LauMahecha/Robotica/Corte_1/Lab_1_y_2_Informe.pdf

INFORME DE PRACTICA DE LABORATORIO | Versi ´ | on 1.0 ´
PROGRAMA DE INGENIERÍA MECATRONICA | Periodo 2026-1 ´
Diseno, Modelado Cinematogr ˜ | afico y Control de ´

# Bajo Nivel de un Manipulador Tipo SCARA

Mahecha Mahecha Laura Julieth, Gonzalez Palacios Wilson Andres, Salmanca Arevalo Cristian Andres y Rodriguez Romero Santiago
Profesor: Velasco Vivas Alexandra
I. INTRODUCCION´

El presente informe presenta el desarrollo integral de un
robot SCARA, el cual es disenado espec ˜ | íficamente para la
manipulacion de piezas ligeras en una celda de manufactura. ´ Este proyecto abarca desde la seleccion de materiales y ´ actuadores, pasando por el modelado matematico mediante ´ los parametros de Denavit-Hartenberg y toda su respectiva ´
configuracion, hasta la implementaci ´ | on de sistemas de control ´
PID de bajo nivel en una plataforma ESP32.

II. OBJETIVOS

Desarrollar la plataforma y el diseno mec ˜ anico del robot ´ utilizando herramientas CAD, optimizando la estructura
mediante impresion 3D y sistemas de transmisi ´ | on en ´
acero para garantizar durabilidad y ligereza.
Obtener el modelo matematico de cinem ´ | atica directa a ´
traves de la metodolog ´ | ía de DH, permitiendo determinar
la posicion del efector final en el espacio del trabajo. ´ Implementar el control PID en un micro, en este cado la ESP32 para gestionar la posicion y velocidad de ´ las articulaciones, utilizando retroalimentacion de los ´ respectivos encoders
Validar los calculos de troque y velocidad mediante simu- ´ laciones para asegurar que los actuadores seleccionados realicen la tarea asignada
Disenar una interfaz gr ˜ | afica de usuario (GUI) que permita ´
el comando remoto del manipulador y la visualizacion de ´ su estado cinematico en tiempo real ´
Integrar un sistema de sujecion por vaci ´ | o (ventosa) como ´
efector final para minimizar la inercia del sistema y
facilitar la manipulacion de objetos esf ´ | ericos ´

III. DESARROLLO DE LA PRACTICA ´

III-A. Justificaciones tecnicas de la arquitectura y selecci ´ | on´
de componentes
Arquitectura Del Manipulador: Se ha seleccionado
una configuracion cinem ´ | atica tipo SCARA (RRP) ya ´
que seria la opcion mas eficiente para la tarea de en- ´ samble requerida. Dado que la operacion que se desea ´ desempenar es tomar piezas en este caso un ping pong y ˜

El presente documento corresponde a un informe de practica de laboratorio ´ de “Robotica” presentado en la Universidad Militar Nueva Granada durante ´ el periodo 2026-1.

posicionarlas sobre una base, el robot SCARA nos ofrece
un eje prismatico el cual cumplir ´ | ía con ese requisito.
Seleccion De Materiales Y Transmisi ´ | on: ´ | En base al
diseno estructural hemos seleccionado imprimirlos en 3D ˜ algunas secciones, como lo son los brazos, ya que estos mismos van a ser huecos, por el simple hecho de que van a tener engranajes y cables en su interior, todo esto con el fin de optimizar el espacio, ya para la parte de potencia, hemos escogido utilizar unos engranajes de acero.

Actuadores Y Control: Para cumplir con los parametros ´ debidamente calculados, decidimos utilizar motores DC con cajas reductoras de engranajes matalicos acoplados a encoders de efecto hall, ya que al implementar el uso del
encoder nos permitira hacer un control tanto de posici ´ | | on´
como de velocidad.
Efector Final (Ventosa De vacio): ´ Se descarto una pinza mecanica y se procedio a implementar un sistema ´
de succion por vaci ´ | o, ya que se realiza con el fin ´
de optimizar la masa, es decir, reducir el peso en eje prismatico del robot.

Lista de Actuadores y Sensores:

Actuadores:
Los actuadores son los encargados de generar el movimiento físico y la sujecion en el robot. ´
1. Motorreductor DC con Encoder (x3) Especificaciones: Modelo 25GA470, alimentacion de ´ 12V DC, velocidad de salida de 100 RPM. Consiste en un motor de corriente continua con escobillas acoplado a una caja reductora metalica. Cumple con la normativa ´ del proyecto de no usar servomotores. Cuenta con un encoder magnetico de cuadratura (canales A y B) en el ´ eje trasero del motor para medir la posicion y velocidad ´ real, permitiendo un control en lazo cerrado para cada articulacion (Hombro, Codo y Eje Z). ´
2. Bomba de Vacío de Membrana
Especificaciones: 12V DC, 300mA. Es el componente activo del efector final para agarrar objetos.
3. Ventosa / Chupa de Silicona

Especificaciones: Diametro de Ø40mm. Trabaja en con- ´ junto con la bomba y el sistema de vacío en el extremo del Eje Z.

Sensores:

Los sensores se encargan de medir el estado del sistema para enviar retroalimentacion (feedback) al controlador. ´

1. Encoders Rotativos (x3)

Especificaciones: 600 PPR (Pulsos Por Revolucion), ali- ´ mentacion de 3.3V. Hay uno acoplado a cada motor (M1, M2 ´ y M3) para monitorear la posicion real de los ejes y crear un ´ sistema de lazo cerrado.

III-B. Diseno CAD del Entorno y Configuraci ˜ | on del Robot ´

Justificacion de la Arquitectura (SCARA) ´

La rubrica permite la selecci ´ | on entre una arquitectura ´
Antropomorfica (RRR) o SCARA (RRP). Para esta l ´ | ínea
de ensamble, se ha seleccionado y disenado una topolog ˜ | ía
SCARA (RRP). Esta decision se justifica por la naturaleza de ´ la tarea: un proceso de (tomar y poner) sobre una superficie plana. El robot SCARA ofrece una alta rigidez en el eje vertical (Z), lo que es ideal para soportar la carga al presionar o depositar las esferas en los agujeros de la base, mientras que sus dos articulaciones rotacionales proporcionan movimientos rapidos y precisos en el plano horizontal (XY). ´


Figura 1. Diseno CAD ˜

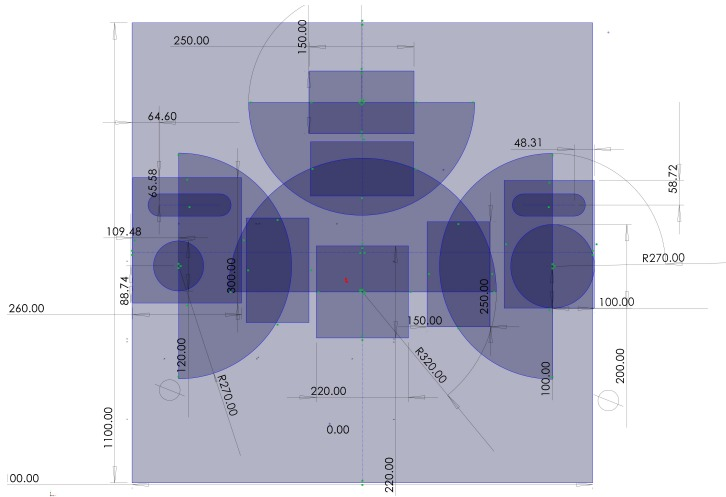
[picture p3: figure]

Figura 3. Espacio de trabajo

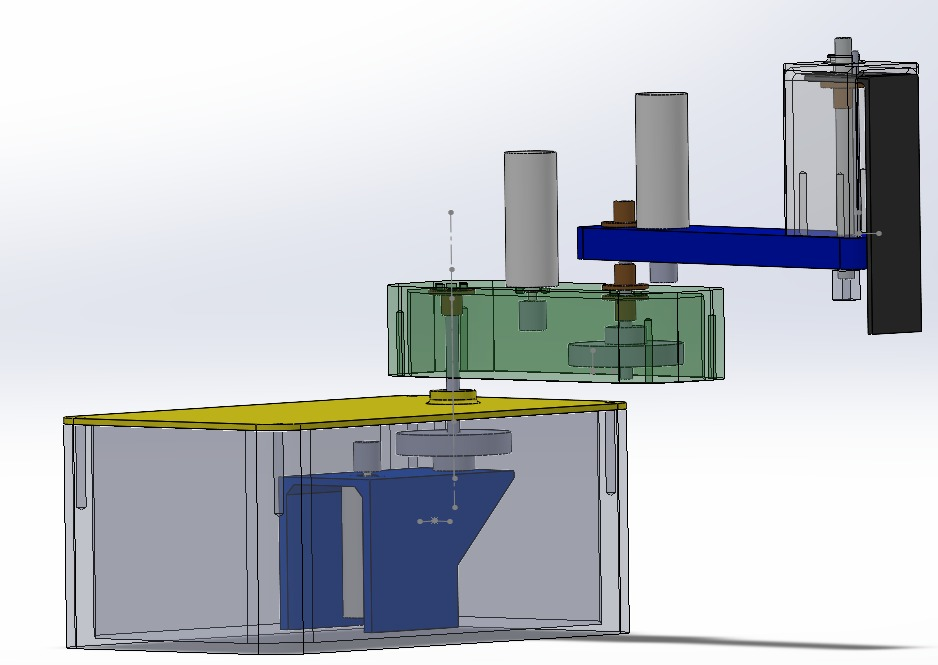
[picture p4: figure]

Figura 2. Diseno CAD ˜

Este diseno fue elegido debido a su alta rigidez en el eje ˜ Z y por su facilidad de controlar el aspecto de la velocidad al momento de hacer la tarea de recoger y colocar los componentes ligeros en este laboratorio.
Como podemos ver el cada parte se a hecho con un volumen cilíndrico hueco, determinado por los limites cinematicos de ´ los eslabones de 112 mm y 155 mm, con ello su alcance
maximo radical es de 267 mm, permitiendo as ´ | í cubrir la
totalidad del area de ensamble que fue asignado, cabe aclarar ´ que esto permite evitar singularidades dentro de la zona de operacion´
Configuracion del Entorno y Espacio de Trabajo ´
III-C. Descripcion de la L ´ | ínea de Ensamble
De acuerdo con los requerimientos del proyecto, se ha
disenado una celda de manufactura contenida en un ˜ | area ´
cuadrada de 1.1 × 1.1 metros (cumpliendo con la restriccion´
maxima de ´ | 1.25 m de arista). El sistema consiste en una línea
de ensamble dividida en tres estaciones de trabajo indepen-dientes. El objetivo central de la celda es el acoplamiento de tres esferas de material ligero (∅ 40 mm, correspondientes a pelotas de ping-pong) en una base rectangular de 25×15×1.5 cm.
Para garantizar que el ensamble no entre en contacto con el
suelo del laboratorio en ningun momento, el dise ´ | no del entorno ˜
incluye soportes físicos elevados en cada estacion. Estos ´ soportes aseguran la fijacion temporal de la base mientras se ´ realiza la insercion de las piezas. ´

III-D. Analisis del Espacio de Trabajo (Workspace) ´

El entorno CAD (Ver Figura 1 y 3) revela la distribucion´ espacial de los manipuladores. Se han definido zonas de trabajo específicas marcadas por las envolventes cinematicas ´ de los robots:
Estacion Central: ´ | Posee un radio maximo de alcance de ´
R = 320 mm. Esta dimension fue calculada para garanti- ´ zar que el efector final pueda alcanzar tanto el repositorio de piezas (fuera de la línea central de ensamble) como los agujeros correspondientes en la base.
Estaciones Laterales: Cuentan con un radio de alcance de R = 270 mm. Al estar ubicadas estrategicamente en ´ los flancos de la línea, requieren una menor extension de ´ eslabones para cubrir su area designada en la superficie ´ de la base.
Dado que los robots operan a una altura superior al suelo mediante los soportes disenados, el volumen de trabajo de cada ˜ robot SCARA se define como un sector cilíndrico. La altura de
este cilindro (carrera del eje prismatico Z) est ´ | a dimensionada ´
para descender desde una cota de seguridad hasta la altura de la base (1.5 cm de espesor) y los repositorios, cumpliendo con
la restriccion de velocidad m ´ | axima de ´ | 0.15 m/s exigida para
articulaciones prismaticas. ´

III-E. Materiales y Consideraciones de Fabricacion´

Para cumplir con los criterios de integridad estructural y baja inercia, los eslabones principales de los robots SCARA y la base del entorno estan dise ´ nados en materiales livia- ˜ nos y de alta resistencia. Atendiendo a las restricciones de
diseno, ˜ | ningun elemento encargado de la transmisi ´ | on de ´
movimiento (engranajes, poleas, pinones) ser ˜ | a fabricado en ´
madera, plastico o mediante t ´ | ecnicas de prototipado r ´ | apido ´
(impresion 3D), garantizando el uso de elementos de transmi- ´ sion met ´ alicos normalizados para reducir la probabilidad de ´ falla y holgura mecanica . ´

III-F. Calculos De Torque Y Velocidades De Los Motores ´

Se realizo un analisis din ´ | amico considerando las inercias ´
de los eslabones, los sistemas de transmision en acero y la ´
carga transportada. Calculos Din ´ | amicos y Requerimientos ´
de Torque Para garantizar que los actuadores seleccionados (motorreductores 25GA470 de 12V y 100 RPM) sean capaces de mover la estructura cumpliendo con las restricciones de
velocidad de la rubrica, se realiz ´ | o un an ´ | alisis din ´ | amico del ´
manipulador.
III-G. Parametros F ´ | ísicos del Modelo
A partir del diseno en CAD y la selecci ˜ | on de materiales, ´
se extrajeron las siguientes variables de diseno para el c ˜ | alculo ´
de inercias y torques:
Longitudes de eslabones: Brazo 1 (L1 = 0.112 m) y Brazo 2 (L2 = 0.155 m).
Masas estructurales: Brazo 1 (m1 = 0.2 kg), Brazo 2 (m2 = 0.25 kg) y Eje Z con efector final (m3 = 0.15 kg).
Carga util: ´ Masa de la pieza a ensamblar (mc = 0.003 kg).
Aceleracion angular: ´ | Se establecio un perfil de mo- ´
vimiento con una aceleracion´ | α = 4 rad/s²
| | para las
articulaciones rotacionales.

III-H. Analisis del Eje 1 (Base/Hombro) ´

El motor de la base (J1) es el encargado de mover la mayor cantidad de masa, por lo que experimenta la mayor inercia del sistema. El momento de inercia calculado para este eje es:

I1 = 0.02072 kg · m

2

Aplicando la segunda ley de Newton para la rotacion, el torque ´
dinamico requerido para acelerar el conjunto a ´ | | 4 rad/s² es:

τ1 = I1 · α = 0.1 Nm

III-I. Analisis del Eje 2 (Codo) ´

El segundo eslabon transporta menos masa al no tener que ´ cargar con el Brazo 1. Su momento de inercia respecto a su propio eje de rotacion es significativamente menor: ´

I2 = 0.005677 kg · m

2

Por lo tanto, el torque dinamico necesario para la articulaci ´ | | on´
J2 es:
τ2 = I2 · α = 0.02271 Nm

Las articulaciones J1 y J2 requieren una velocidad maxima de ´ 2 rad/s, lo que equivale a 19.098 RPM. Dado que los motores seleccionados proporcionan 100 RPM nominales, operaran´
holgadamente y requeriran limitaci ´ | on por PWM o reducci ´ | on´
mecanica para no exceder la velocidad permitida. ´
III-J. Analisis del Eje 3 (Articulaci ´ | on Prism ´ | atica) ´

El movimiento vertical del Eje Z debe contrarrestar la fuerza de gravedad ejercida por su propia masa y la carga util. La ´ fuerza gravitacional total en el eje es de 1.5 N.Para lograr la conversion de movimiento rotacional a lineal cumpliendo ´ con la velocidad exigida de 0.15 m/s, se analizaron dos
mecanismos de transmision. Se opt ´ | o por un sistema de ´ | pinõn- ´
cremallera con un radio de pinõn´ r = 0.01 m. Para alcanzar la velocidad lineal maxima exigida, el motor J3 debe girar a: ´

ω3 =

v
r

=

0.15 m/s
0.01 m

= 15 rad/s ≈ 143.31 RPM

El torque requerido para vencer la gravedad mediante este sistema de pinõn-cremallera se establece en: ´

τ3 = Fz · r = 1.5 N · 0.01 m = 0.015 Nm

Como el torque maximo demandado por el sistema es de ´ 0.1 Nm (en el Eje 1), los motor-reductores 25GA470 son completamente aptos para la tarea, operando sin riesgo de sobrecarga o bloqueo.
Justificacion Adicional de Subsistemas ´

III-K. Diseno del Efector Final (Sistema de Agarre) ˜

Para la tarea de manipulacion ( ´ pick-and-place) de las piezas de ensamble (esferas de material ligero de ∅ 40 mm), se
evaluaron distintas alternativas de sujecion. Se descart ´ | o el uso ´
de pinzas mecanicas (grippers) debido a que su accionamiento ´ requiere actuadores adicionales en el extremo del brazo, lo cual incrementaría significativamente la masa (m3), la inercia del sistema y la complejidad del control.
En su lugar, se opto por un ´ | sistema de sujecion por vac ´ | ío.
La solucion propuesta est ´ | a compuesta por: ´
Una ventosa o copa de sujecion de silicona de ´ | 40 mm
de diametro, que se adapta perfectamente a la curvatura ´
de la esfera, garantizando un sello hermetico sin da ´ | nar ˜
la pieza.
Una bomba de vacío de membrana accionada a 12V DC, ubicada estrategicamente en la base del robot o en el Eje ´ Z para minimizar el momento de inercia.
Un modulo rel ´ | e de 5V (SRD-05VDC) comandado por ´
un pin digital del microcontrolador ESP32, aislando la etapa de potencia de la etapa logica. ´
Este diseno resulta ser mucho m ˜ | as ligero, r ´ | apido de accionar ´
y energeticamente eficiente para la carga ´ | util espec ´ | ífica del
proyecto (0.003 kg).
Calculos Te ´ | oricos: Cinem ´ | atica Directa (20 %) ´
El modelo cinematico directo de un manipulador permite ´
determinar la posicion y orientaci ´ | on del efector final en el ´
espacio cartesiano (x, y, z) a partir de los valores articulares dados (angulos de los motores y desplazamiento lineal). Para el ´ robot SCARA (arquitectura RRP) propuesto, se ha empleado
la convencion de Denavit-Hartenberg (D-H) est ´ | andar para ´
asignar los sistemas de coordenadas a cada eslabon. ´

III-L. Parametros de Denavit-Hartenberg ´

A partir del diseno CAD establecido, se definen los siguien- ˜
tes parametros geom ´ | etricos: ´
L0: Altura de la base hasta el plano del primer brazo.
L1: Longitud del primer eslabon ( ´ | 0.112 m).
L2: Longitud del segundo eslabon ( ´ | 0.155 m).
d3: Desplazamiento de la articulacion prism ´ | atica (Eje Z), ´
el cual es variable.

La Tabla 1 resume los parametros D-H del manipulador, ´
donde θi es el angulo de la articulaci ´ | on, ´ | di el desfase en el
eslabon, ´ | ai
la longitud del eslabon y ´ | αi el giro del eslabon. ´

A partir del diseno CAD establecido, se evidencian desfases ˜ verticales debido al montaje superpuesto de los eslabones y la ubicacion del actuador final. Se definen los siguientes ´
parametros geom ´ | etricos (en metros): ´

Tabla I
PARAMETROS ´ | DENAVIT-HARTENBERG REALES DEL ROBOT SCARA
DISENADO ˜
Articulacion ( ´ | i) | θi (Angulo Z) ´ | di (Desfase Z) | ai (Longitud X) | αi (Giro X)
1 (Hombro) | θ1
∗ | 0.063 | 0.112 | 0
| | | | | ◦
2 (Codo) | θ2
∗ | 0.115 | 0.155 | 180◦
3 (Eje Z) | 0 | 0.148 | 0.035 | 0
| | | | | ◦

(*) Variables articulares. Valores de di y ai expresados en metros.

III-M. Matrices de Transformacion Homog ´ | enea ´
Aplicando la matriz de transformacion general de D-H ´ A

i−1
i

, se obtienen las matrices individuales para cada articulacion: ´

A

0
1 =

cos(θ1) − sin(θ1) 0 L1 cos(θ1)
sin(θ1) | cos(θ1) | 0 L1 sin(θ1)
0 | 0 | 1 | L0
0 | 0 | 0 | 1

(1)

A

1
2 =

cos(θ2) | sin(θ2) | 0 | L2 cos(θ2)
sin(θ2) − cos(θ2) | 0 | L2 sin(θ2)
0 | 0 | −1 | 0
0 | 0 | 0 | 1

(2)

A

2
3 =

1 0 0 | 0
0 1 0 | 0
0 0 1 d3
0 0 0 1

(3)

III-N. Ecuaciones Finales de Posicion´
La matriz de transformacion total ´ | T

0
3 que relaciona el
efector final con la base del robot se obtiene mediante la
multiplicacion sucesiva de las matrices individuales ( ´ | | T
| | 0 3 =
A⁰
1
- A¹
2
- A²
3

). Al resolver esta multiplicacion, se extrae el ´ vector de posicion cartesiana: ´

Px = L1 cos(θ1) + L2 cos(θ1 + θ2) | (4)
Py = L1 sin(θ1) + L2 sin(θ1 + θ2) | (5)
| Pz = L0 − d3 | (6)

Estas tres ecuaciones parametricas constituyen el modelo ´
cinematico directo. Ser ´ | an utilizadas posteriormente por el ´
algoritmo de control para validar la posicion del robot dentro ´ del espacio de trabajo y evitar colisiones con los soportes de la base de ensamble.
Validacion del Modelo Cinem ´ | atico en Simulaci ´ | on´
Para garantizar la fiabilidad del modelo matematico desa- ´
rrollado en la seccion de Cinem ´ | atica Directa, se procedi ´ | o a ´
realizar una validacion computacional mediante simulaci ´ | | on. ´
Para este proposito, se emple ´ | o el software MATLAB Online ´
junto con el Robotics Toolbox de Peter Corke.

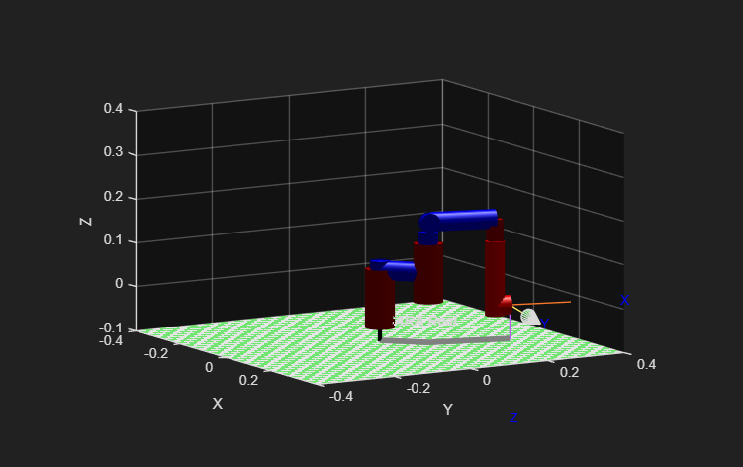
[picture p5: figure]

Figura 4. Simulacion del brazo scara en el software Matlab

III-N. ˜ | Implementacion en Simulaci ´ | on´

El robot SCARA fue instanciado utilizando la clase SerialLink. Se configuraron las articulaciones 1 y 2 mediante la clase Revolute y la articulacion 3 median- ´ te Prismatic, ingresando los parametros de Denavit- ´ Hartenberg (D-H) calculados previamente.
En la figura 4 se observa el modelado espacial del robot generado por la funcion´ plot().

III-O. Analisis de Resultados y Ecuaciones Finales ´
Al aplicar los parametros reales del dise ´ | no CAD en la ˜
multiplicacion de las matrices de Denavit-Hartenberg, las ´
ecuaciones parametricas de posici ´ | on espacial para el efector ´
final (coordenadas X, Y, Z) se definen como:
Px = a1 cos(θ1) + (a2 + a3) cos(θ1 + θ2) | (7)
Py = a1 sin(θ1) + (a2 + a3) sin(θ1 + θ2) | (8)
Pz = d1 + d2 − offset3 − d3 | (9)
Para la validacion del modelo, se evalu ´ | o un vector articular ´
de prueba q = [45◦
| , 30◦ , 0.05 m] T
en las ecuaciones analíticas desarrolladas, obteniendo:

Px = 0.112 cos(45◦

) + (0.155 + 0.035) cos(75◦
| | ) = 0.1284 m (10)

Py = 0.112 sin(45◦

) + (0.155 + 0.035) sin(75◦
| | ) = 0.2627 m (11)
Pz = 0.063 + 0.115 − 0.148 − 0.05 = −0.0200 m | (12)

Estos resultados teoricos se compararon directamente con ´
el vector de posicion extra ´ | ído de la matriz de transformacion´
homogenea calculada por la funci ´ | on´ | fkine del Robotics
Toolbox:

PT oolbox =

0.1284
0.2627
−0.0200
- m | (13)

La coincidencia exacta hasta la cuarta cifra decimal entre el desarrollo analítico propio y el calculo matricial de la si- ´
mulacion valida de manera concluyente el modelo cinem ´ | atico ´
directo del manipulador.

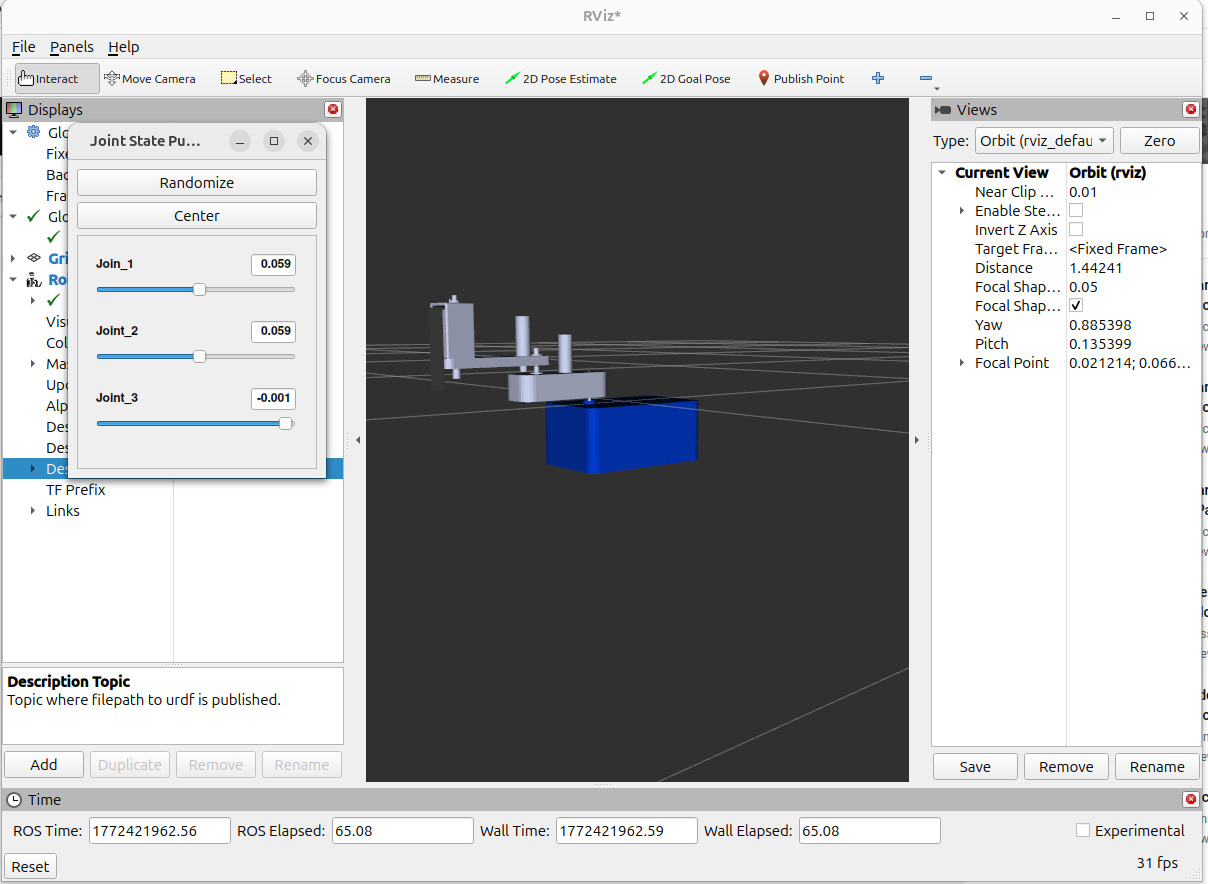
[picture p6: figure]

Figura 5. Simulacion del robot scara en el software ROS2

Simulacion en el entorno ROS2 ´
Para el entorno en ROS2 en primera instancia se generó el URDF desde el SOLIDWORKS, apoyando la geometría, ejes de referencia y puntos de origen del robot en cada una de sus articulaciones, así mismo se verifico que la accion de ´ cada punto correspondiera de acuerdo a la geometría propia del robot, una vez generado esto se procede a desde el RViZ desde el cual se configuro para ls visualizacion, se creo un ´ work space con los ejecutables del ros2. Así mismo dentro del RVIZ se configuran algunos sliders con los que se permite el movimiento en cada articulacion. Se observa en la figura 5 ´ respectivamente.

Desarrollo de la Interfaz Grafica de Usuario (GUI) ´ Para visualizar y validar el comportamiento cinematico del ´

manipulador SCARA de forma interactiva, se desarrollo una ´ Interfaz Grafica de Usuario (GUI) utilizando el lenguaje de ´ programacion Python. ´
La aplicacion se construy ´ | o integrando las siguientes li- ´
brerías principales:
Tkinter: Utilizada para estructurar la ventana principal, los paneles de control y los elementos de interaccion´ (deslizadores y cuadros de texto).
NumPy: Empleada para el manejo matricial eficiente,
permitiendo el calculo en tiempo real de la cinem ´ | atica ´
directa mediante la multiplicacion de las matrices de ´
transformacion homog ´ | enea de Denavit-Hartenberg. ´
Matplotlib: Implementada para generar un entorno tridi-mensional (espacio de trabajo) incrustado en la interfaz, donde se renderizan los eslabones del robot.

III-P. Estructura y Funcionamiento de la GUI
Como se observa en la figura 5, la interfaz esta dividida en ´ dos secciones principales:
1. Panel de Control (Izquierda): Permite al usuario mo-dificar los parametros articulares del robot de manera ´

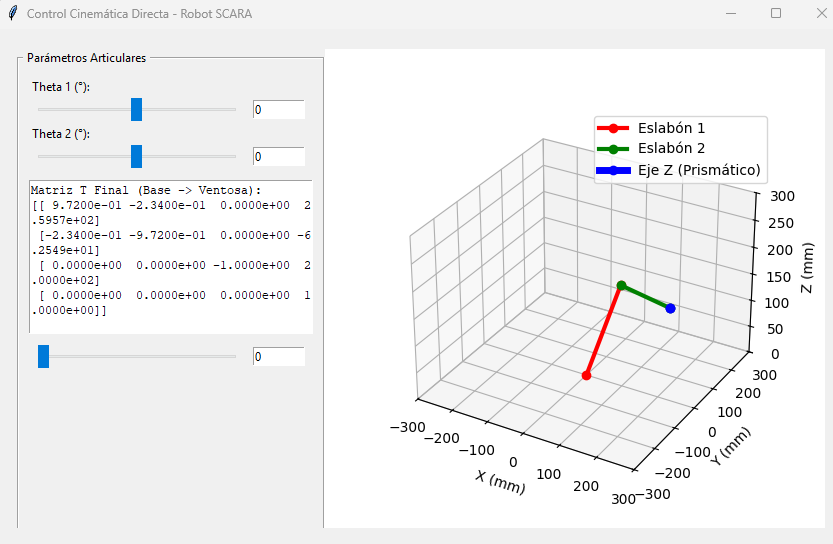
[picture p7: figure]

Figura 6. Interfaz Grafica de Usuario para el control cinem ´ | atico directo del ´
robot SCARA

manual. Cuenta con controles deslizantes (sliders) para
los angulos de las articulaciones rotacionales ( ´ | θ1 y θ2)
y para el desplazamiento lineal del efector final (d3).
Ademas, incluye un ´ | area de texto que imprime en tiempo ´
real la Matriz de Transformacion Homog ´ | enea resultante ´
desde la base hasta la ventosa/efector.
2. Simulador 3D (Derecha): Muestra una representacion´ grafica y simplificada de la estructura del manipulador. ´
Esta visualizacion se actualiza din ´ | amicamente cada vez ´
que el usuario modifica un parametro en el panel iz- ´ quierdo, permitiendo observar la postura final del robot
(posicion y orientaci ´ | on) dentro de su espacio de trabajo. ´
Esta herramienta interactiva permite corroborar visual y
matematicamente que los l ´ | ímites de las articulaciones y las
longitudes de los eslabones coinciden con el diseno CAD ˜ propuesto, sirviendo como un entorno de validacion integral ´ previo a la implementacion f ´ ísica o al control dinamico. ´

III-Q. Plano Electrico

Como se observa en el diagrama general del sistema (Ver Figura 8), la arquitectura electronica se divide en cuatro ´ bloques funcionales principales:
Unidad de Procesamiento: El nucleo del sistema es ´ un microcontrolador ESP32-WROOM. Este dispositivo gestiona la generacion de pulsos para los motores, la ´ lectura de los encoders y la comunicacion con la interfaz ´ de usuario.
Etapa de Potencia y Accionamiento: El movimiento de los ejes se realiza mediante tres motores paso a paso NEMA 17. Cada motor es controlado por un driver
A4988, los cuales reciben las senales de ˜ | Step y Direction
desde los pines GPIO del ESP32. El Eje Z cuenta con un mecanismo de tornillo de bolas para la traslacion vertical. ´
Sistema de Retroalimentacion (Lazo Cerrado): ´ | Para
garantizar la precision posicional, se han implementado ´ tres encoders magneticos de cuadratura (600 PPR). Estos ´ sensores envían pulsos constantes al ESP32 (Pines GPIO

34-39 y 18-19), permitiendo corregir desviaciones en tiempo real.
Gestion de Energ ´ | ía: El sistema utiliza una fuente de
12V DC para la etapa de potencia (motores y bomba).
Para la etapa logica, se integra un regulador ´ | | AMS1117-
5V que suministra un voltaje estable al microcontrolador
y al modulo rel ´ | e.´
Efector Final de Succion: ´ | El control del agarre se realiza
mediante un modulo rel ´ | e de 5V que activa una ´ | bomba de
vacío de membrana. El sistema incluye un diodo flyback para la proteccion contra corrientes inversas durante la ´ conmutacion. ´

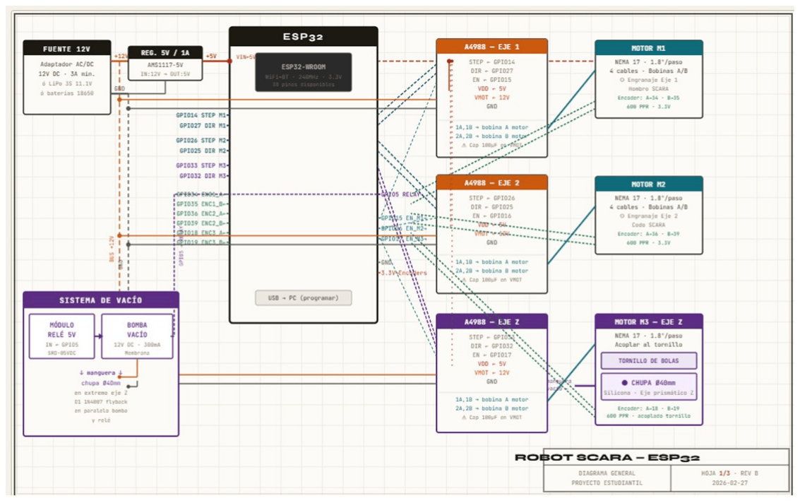
[picture p8: figure]

Figura 7. Diagrama esquematico detallado del sistema de control y potencia ´ del Robot SCARA - ESP32.

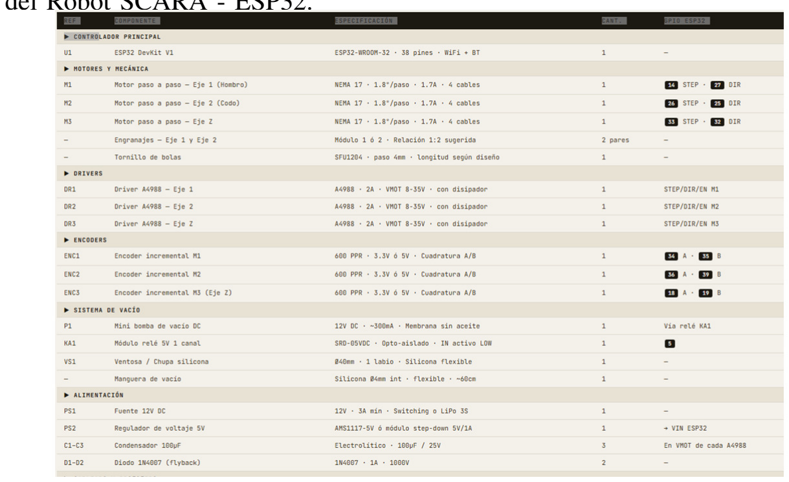
[picture p9: figure]

Figura 8. Diagrama esquematico 2 ´

III-R. Especificaciones de Interconexion´
La Tabla II resume la asignacion de pines cr ´ | íticos identi-
ficados en el diseno, asegurando la integridad de las se ˜ | nales ˜
entre la etapa de control y los actuadores.

Tabla II
RESUMEN DE ASIGNACION DE ´ | PINES GPIO DEL ESP32.
Componente | Senales de Control ˜ | Pines GPIO
Motor Eje 1 (Hombro) | Step / Dir / En | 14, 27, 15
Motor Eje 2 (Codo) | Step / Dir / En | 26, 25, 16
Motor Eje Z (Prismatico) ´ | Step / Dir / En | 33, 32, 17
Modulo Rel ´ e (Vac ´ ío) | Activacion´ | 5

III-S. Descripcion de Componentes Mec ´ | anicos ´
Como se detalla en la Figura 6, el conjunto mecanico utiliza ´ piezas fabricadas mediante manufactura aditiva (impresion´ 3D) para las carcasas y soportes, mientras que los elementos críticos de transmision emplean materiales de alta resistencia. ´ Estructura Base y Brazos: Las piezas como la Base Robot (1) y el Brazo 2 (9) han sido disenadas para ˜ alojar internamente el cableado y los actuadores, optimizando el volumen de trabajo.
Transmision de Movimiento: ´ | Se utilizan Varillas de
Acero (6) para garantizar la rigidez estructural. La transmision se realiza mediante un sistema de poleas ´ (4 y 5) que conectan los motores con las articulaciones rotacionales.
Eje Prismatico Z: ´ | Para el movimiento vertical, se em-
plea un Tornillo de Bolas (12) acoplado a una guía lineal, lo cual garantiza la precision necesaria para la tarea de ´ ensamble.

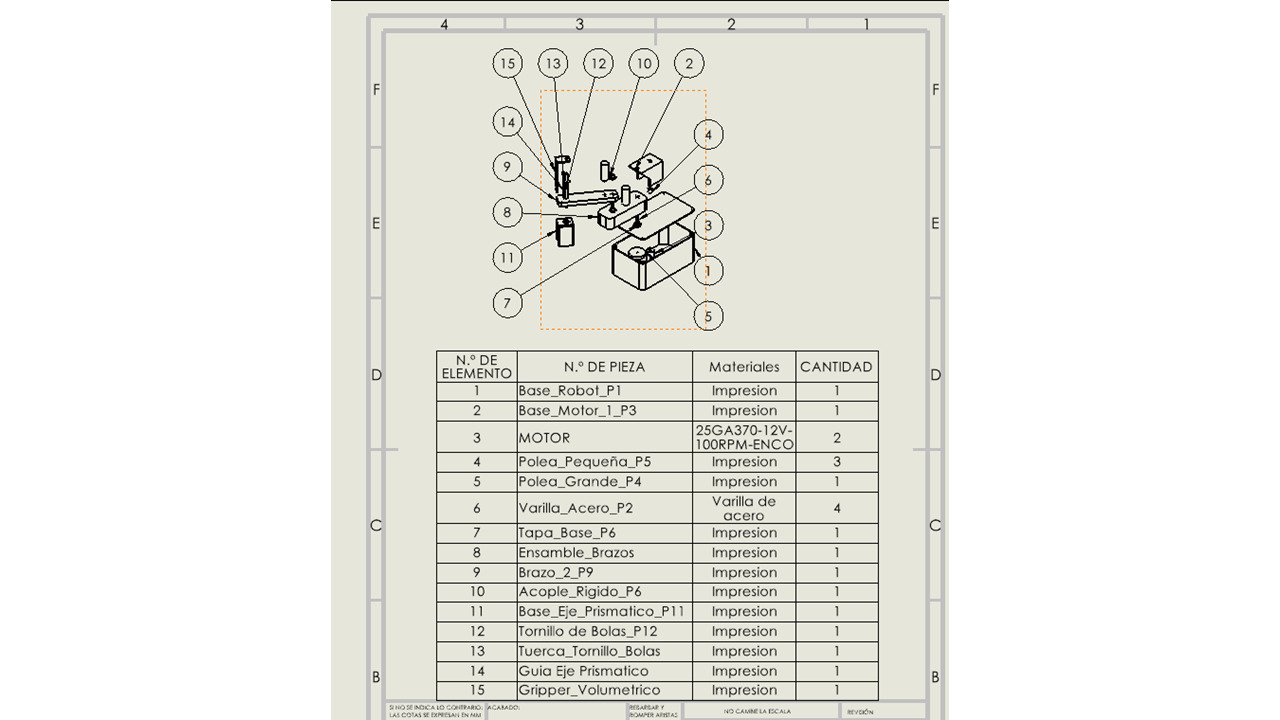
[picture p10: figure]

Figura 9. Plano mecanico con vista explosionada y lista de materiales (BOM). ´

Analisis de Resultados: Control en Cascada ´
La implementacion del control en cascada para el motor ´ 25GA370 permite desacoplar efectivamente las dinamicas de ´
velocidad y posicion[cite: 364, 367]. A continuaci ´ | | on se deta- ´
llan los hallazgos obtenidos en la fase de diseno y simulaci ˜ | on. ´

III-T. Identificacion y Planta ´
Los parametros identificados mediante el script de ´ MATLAB revelan una resistencia de armadura Ra = 8.00 Ω y una inductancia La = 0.0050 H[cite: 203, 208]. La constante de torque Kt y la constante de fuerza contraelectromotriz Kb
resultaron identicas con un valor de ´ | 0.6867 en unidades del
sistema internacional [cite: 209, 210], lo que confirma una operacion bajo condiciones de eficiencia ideal[cite: 204]. ´

III-U. Control de Velocidad (Lazo Interno)
El lazo interno fue disenado para un tiempo de estable- ˜
cimiento ts = 0.5 s y un sobreimpulso maximo del ´ | 5 %[cite:
266, 271]. Los parametros del controlador PID resultantes son ´ Kp = 15.00, Ki = 40.00 y Kd = 0.0500[cite: 268, 274].
La respuesta ante un escalon de ´ | | 1 rad/s muestra una
convergencia rapida y sin error de estado estacionario debido ´
a la accion integral[cite: 299]. La se ´ | nal de error ˜ | ev(t) decae

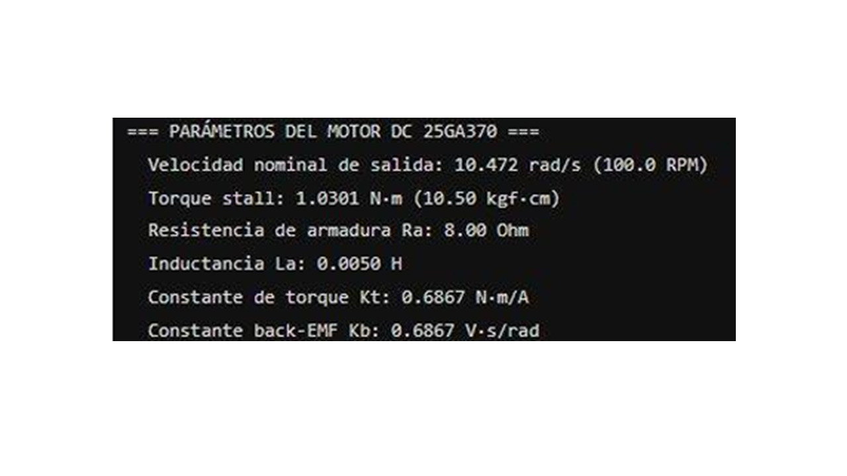
[picture p11: figure]

Figura 10. Variables de estado y parametros electromec ´ | anicos calculados para ´
el motor 25GA370[cite: 211].

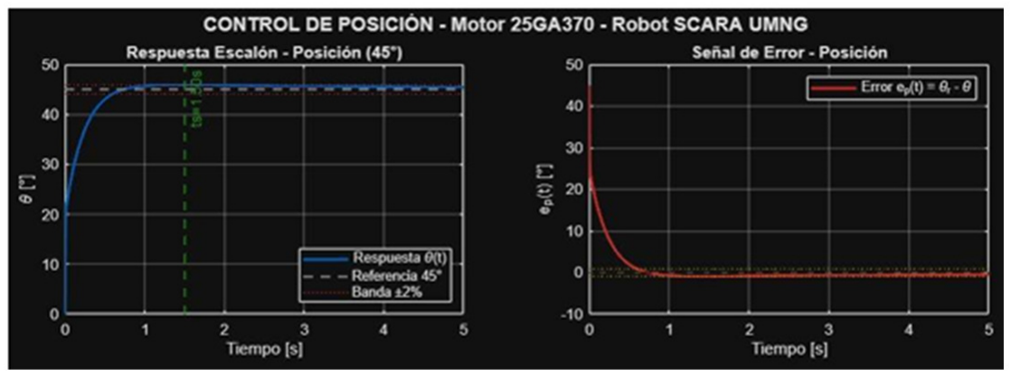
[picture p12: figure]

Figura 11. Respuesta transitoria ante un escalon de ´ 45◦ y seguimiento de la referencia de posicion[cite: 330, 363]. ´

exponencialmente, entrando en la banda de tolerancia del 2 % antes del límite previsto de 0.5 s[cite: 300, 329].

III-V. Control de Posicion (Lazo Externo) ´
Para el lazo de posicion, se establecieron criterios de dise ´ | nõ
de ts = 2.0 s y un sobreimpulso del 10 %[cite: 283, 287]. Los valores sintonizados para este controlador son Kp = 8.00, Ki = 1.50 y Kd = 0.800[cite: 284, 287].
III-W. Separacion de Din ´ | amicas ´
La estabilidad del sistema en cascada se fundamenta en la separacion de las constantes de tiempo entre ambos lazos[cite: ´ 367]. El lazo interno de velocidad responde en aproximadamente 0.3 s, mientras que el lazo externo de posicion lo hace ´ en un rango de 1.5 a 2.0 s[cite: 366]. Esta diferencia, con un factor de aproximadamente 5-7 veces, asegura que la dinamica ´ interna no interfiera negativamente con el seguimiento de posicion[cite: 367]. ´
IV. ANALISIS ´ | DE RESULTADO

Podemos ver y saber que al momento de realizar un control de velocidad y de posicion se comporta bastante acorde a los parametros y con respecto a las ganancias que les dimos, no obstante cabe aclarar que a pesar de que cada motor tenga la misma referencia se comportan de manera diferente, es decir, las ganancias pueden cambiar.

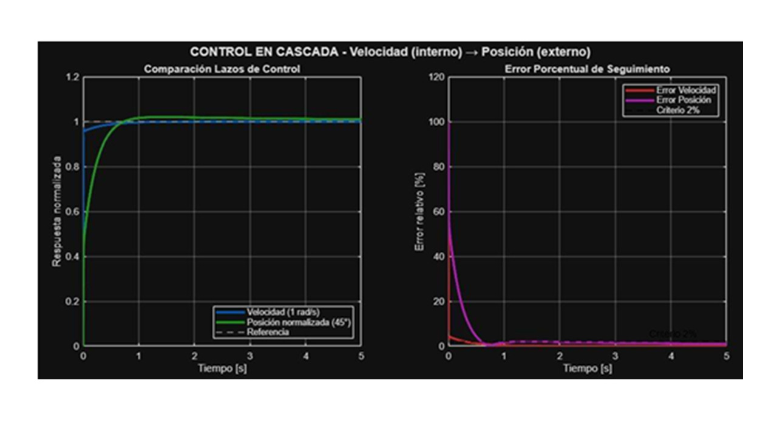
[picture p13: figure]

Figura 12. Comparacion de los lazos de control y error relativo porcentual ´ inferior al 2 %[cite: 368, 400].

Podemos ver que garantiza ambas dinamicas de posicion y velocidad, ya que no interfieren entre si, debido a que el control de velocidad responde a 3 segundos y el control de posicion reacciona entre 1.5 a 2 segundos
Podemos ver que la validacion cinematica, se hicieron para el vector articular de prueba q=[45 30 0.05] y pudimos ver que coinciden debidov a que utilizamos el sistema de Robotics Toolbox de MATLAB
V. CONCLUSIONES
En el control de cascada se pudo ver que este metodo es solido para el control del robot, ya que esto permitiria controlar las articulaciones con mayor facilidad el robot Las herramientas de MATLAB permitieron visualizar el comportamiento que deberia obtener el robot y a la ves corroborando que los calculos matematicos son coherentes y funcionales
