LauMahecha/Robotica/Corte_1/Entrega 2.pdf

Nombres: | Santiago Rodriguez Romero
| Laura Mahecha
| Cristian Salamanca
| Wilson Gomez
| Segunda entrega
1. Justificación del diseño: Para la solución del problema se escogió un robot de tipo SCARA con 3 grados de libertad, el efector final es una ventosa con la que se pretende recoger el ping pon de manera más sencilla, se van a implementar motores DC con enconder convencionales y el sistema de transmisión de potencia es por medio de poleas dentadas, con el que se pretende garantizar una buena transferencia de potencia desde el motor a los eslabones.
Ahora bien, de acuerdo con el proyecto que se tiene, se plantean movimientos en X y Y, con movimientos en Z para subir y bajar, más no se requieren posiciones en ubicaciones complejas del espacio, lo que ocasiona que el efector no tenga posiciones complejas. También debido a la ubicación de los pings pon y con el fin de que no se sobre dimensione el robot, la configuración SCARA permite obtener unos motores con menor torque, así mismo la inercia del motor es mejor, por lo que es mejor.
De la misma manera viéndolo desde el lado de ROS2 se infiere que el desarrollo en gazebo es más estable, por lo que se cuenta con menos efectos de la gravedad en la rotación y la simulación es más estable. Adicionalmente al momento de desarrollar la cinemática es mucho más sencillo.
Por otro lado, se pretende implementar una ESP32 con la que se busca simplificar el proceso de programación, ella se encargara del control de los motores por medio de un PID discreto.

Sección externa:
0.04 × 0.02 = 0.0008 m²
Hueco interno:
(0.034 × 0.014) ≈ 0.000476 m² Área efectiva:
0.0008 − 0.000476 = 0.000324 m² Volumen:
0.000324 × 0.22 = 7.13×10⁻⁵ m³ Masa:
1250 × 7.13×10⁻⁵ ≈ 0.089 kg

Brazo 1 ≈ 90 g
Brazo 2 ≈ 75 g aprox

τ2 = 0.075(9.81)(0.09) + 0.15(9.81)(0.18)

= 0.066 + 0.265

τ2 ≈ 0.33 Nm

Con factor de seguridad ×2:

τ2 ≈ 0.7 Nm
Calculando:
- 0.097
- 0.647
- 0.228
- 0.589

τ1 ≈ 1.56 Nm

Con seguridad ×2:

τ1 ≈ 3.1 Nm
Supongamos:
- Polea motor = 20 dientes
- Polea eje = 60 dientes
- Relación = 3:1
Entonces el motor solo necesita:

τmotor1 =

3.1
3

≈ 1.03Nm

Perfectamente alcanzable con:
- Motor DC 0.2 Nm nominal

- Reductor 10:1
- Más polea 3:1
Total ≈ 6 Nm disponibles
2. Bocetos:

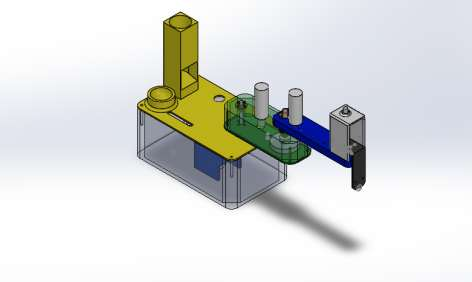
[picture p14: figure]

3. Matriz DH:

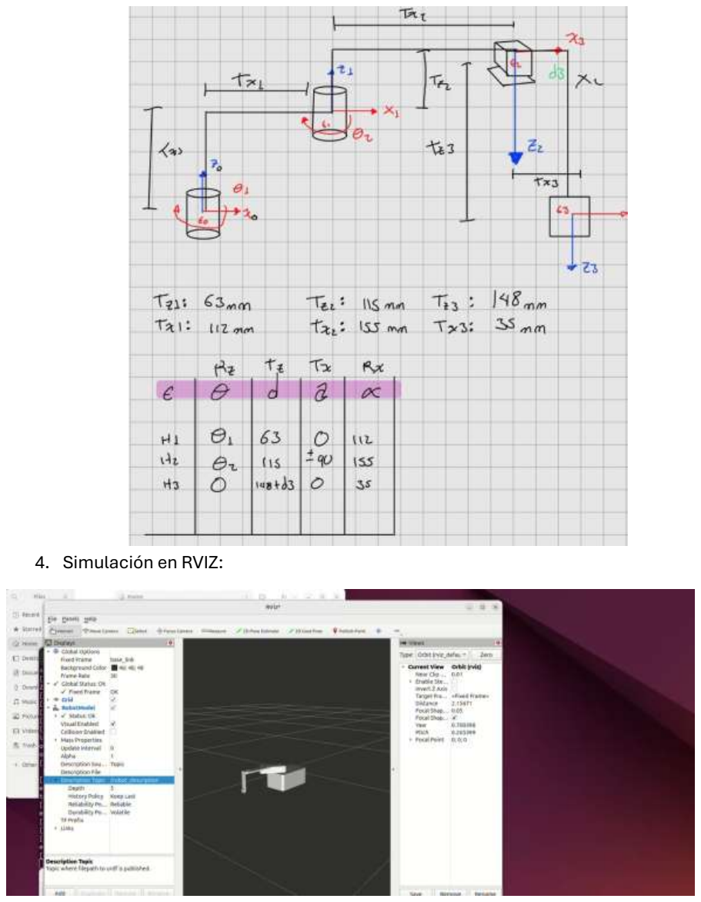
[picture p15: page 4]

4. Simulación en RVIZ:
