LauMahecha/Robotica/Corte_2/Robot CAD/Robot Scara 3GDL/Cama ampolleta.TIF

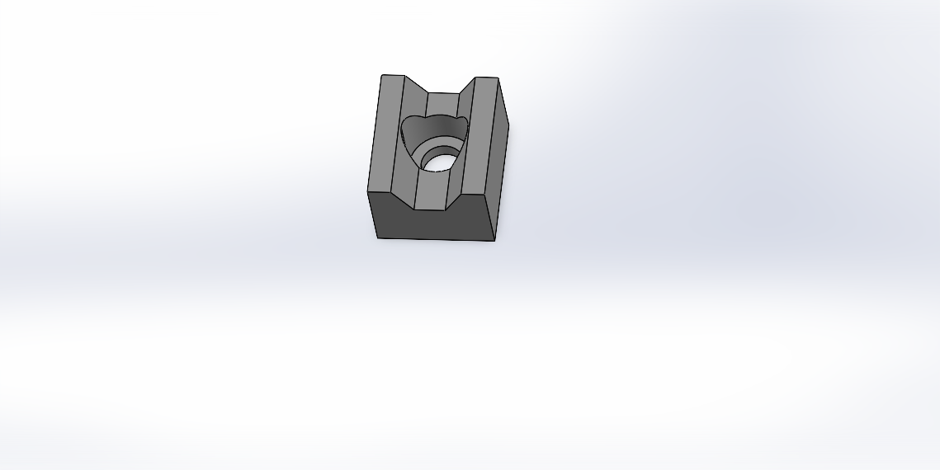
Corte_2/Robot CAD/Robot Scara 3GDL/Cama ampolleta.TIF
