LauMahecha/Robotica/Corte_2/Robot CAD/Robot Scara 3GDL/Ensamble_Volumetrico.SLDASM

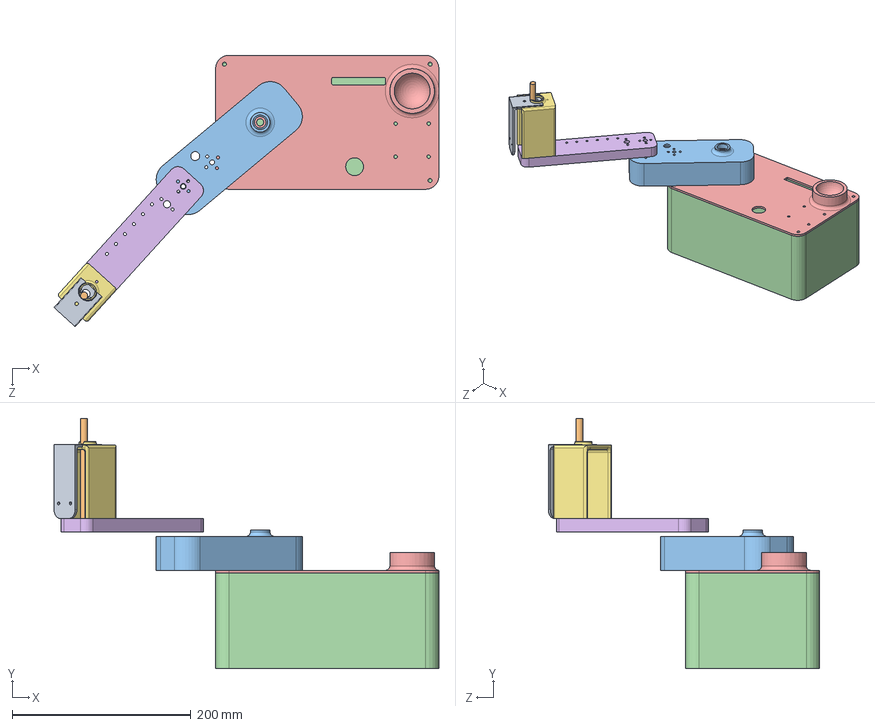
[picture p17: CAD file, 2026-03-20]
Corte_2/Robot CAD/Robot Scara 3GDL/Ensamble_Volumetrico.SLDASM
430.6 x 280.0 x 303.7 mm
Base_Eje_Prismatico_P11
Brazo_2_P9
Tapa_Base_P6
Base_Robot_P1
Brazo_1_P8
Tornillo de Bolas_P12
Gripper_Volumetrico
