LauMahecha/Robotica/Corte_2/Robot CAD/Robot Scara 3GDL/Ensamble_Robot_Scara.SLDASM

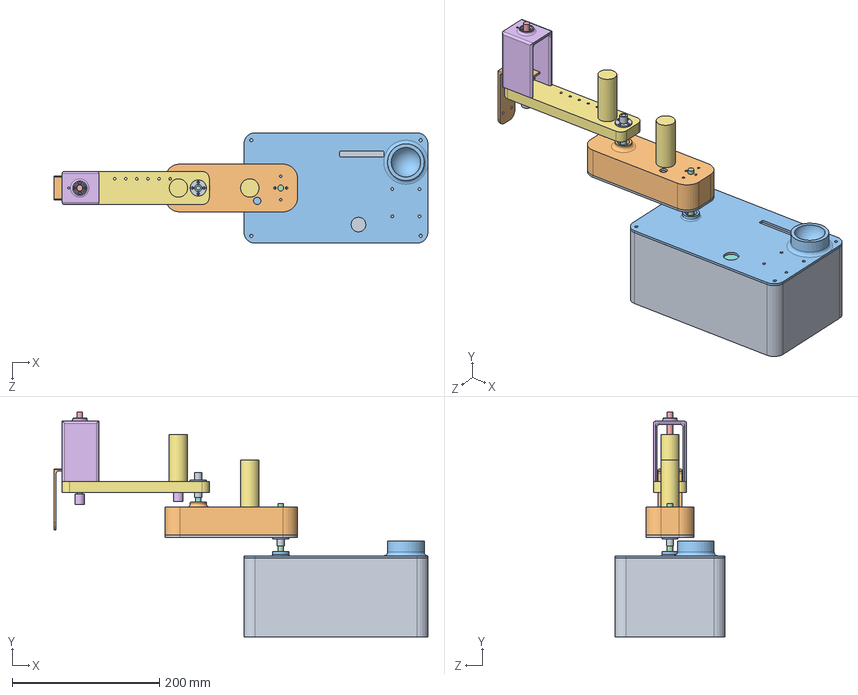
[picture p18: CAD file, 2026-03-20]
Corte_2/Robot CAD/Robot Scara 3GDL/Ensamble_Robot_Scara.SLDASM
508.0 x 305.0 x 150.0 mm
Base_Robot_P1
Base_Motor_1_P3
MOTOR x 3
Polea_Pequeña_P5 x 4
Polea_Grande_P4 x 2
Varilla_Acero_P2
Tapa_Base_P6
Brazo_1_P8
Acople_Rigido_P6 x 4
Varilla_Acero_2_P10
Brazo_2_P9
Base_Eje_Prismatico_P11
Tornillo de Bolas_P12
Tuerca_Tornillo_Bolas
Guia Eje Prismatico
Gripper_Volumetrico
Tapa Eslabon 1
