LauMahecha/Robotica/Corte_2/Robot CAD/Robot Scara 3GDL/Ensamble_Brazos.SLDASM

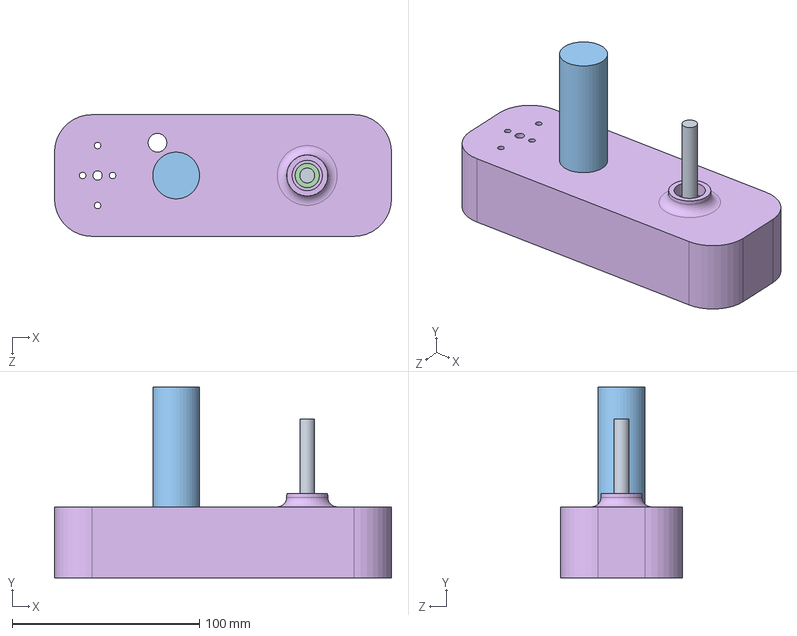
[picture p19: CAD file, 2026-03-20]
Corte_2/Robot CAD/Robot Scara 3GDL/Ensamble_Brazos.SLDASM
180.0 x 102.0 x 65.0 mm
Brazo_1_P8
Acople_Rigido_P6
Polea_Grande_P4
MOTOR
Polea_Pequeña_P5
Varilla_Acero_2_P10
