LauMahecha/Robotica/Corte_2/Robot CAD/Robot Scara 3GDL/Archivos de Impresión/Base_Robot_P1.STL

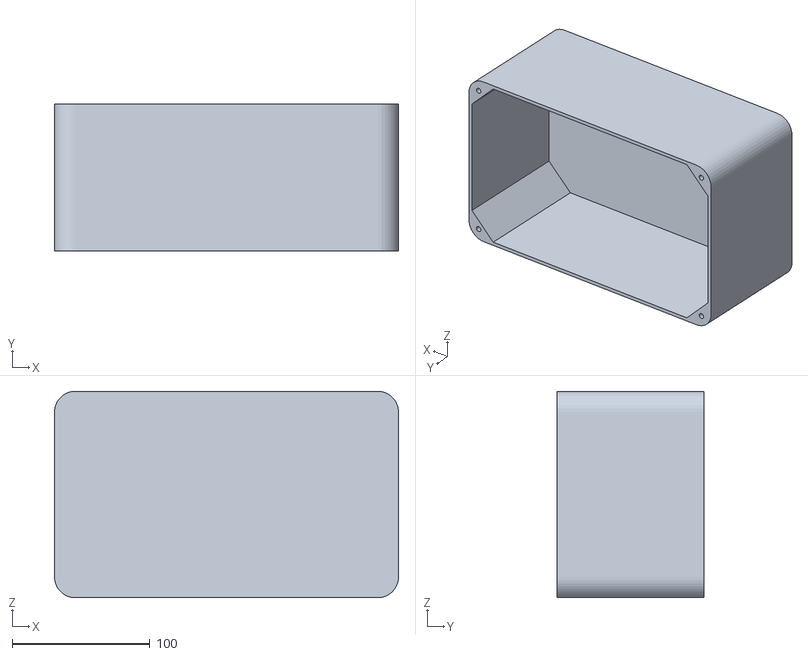
[picture p20: CAD file, 2026-03-20]
Corte_2/Robot CAD/Robot Scara 3GDL/Archivos de Impresión/Base_Robot_P1.STL
250.0 x 107.0 x 150.0
