LauMahecha/Robotica/Corte_2/Robot CAD/Robot Scara 3GDL/Varilla_Acero_P2.SLDPRT

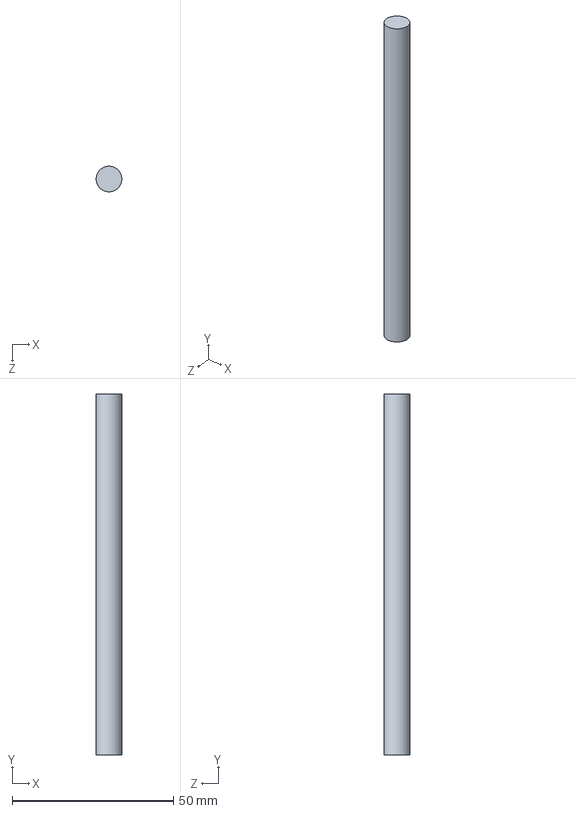
[picture p21: CAD file, 2026-03-20]
Corte_2/Robot CAD/Robot Scara 3GDL/Varilla_Acero_P2.SLDPRT
8.00 x 112.0 x 8.00 mm
