LauMahecha/Robotica/Corte_2/Robot CAD/Robot Scara 3GDL/Archivos de Impresión/Tapa Eslabon 1.STL

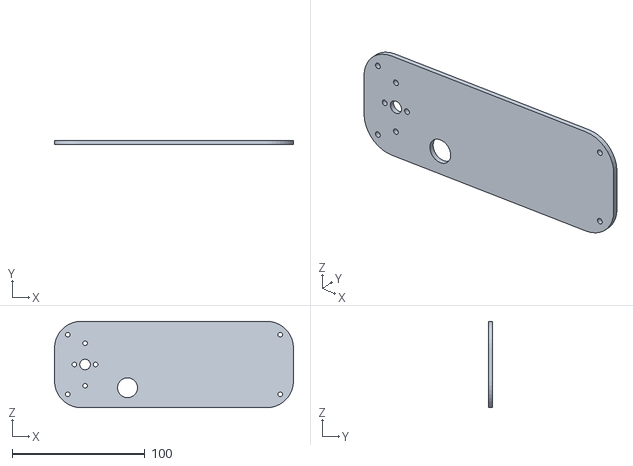
[picture p22: CAD file, 2026-03-20]
Corte_2/Robot CAD/Robot Scara 3GDL/Archivos de Impresión/Tapa Eslabon 1.STL
180.0 x 3.00 x 65.0
