LauMahecha/Robotica/Corte_2/Robot CAD/Robot Scara 3GDL/Brazo_2_P9.SLDPRT

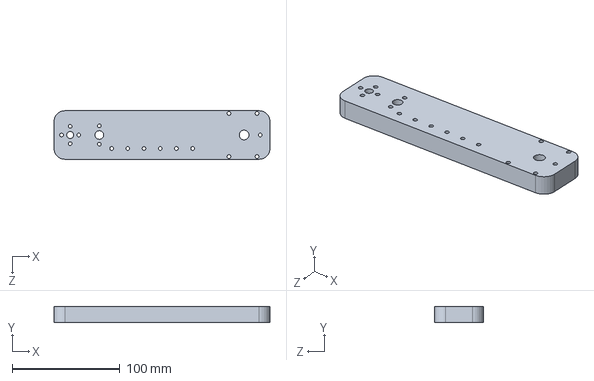
[picture p23: CAD file, 2026-03-20]
Corte_2/Robot CAD/Robot Scara 3GDL/Brazo_2_P9.SLDPRT
200.0 x 15.0 x 45.0 mm
