LauMahecha/Robotica/Corte_2/Robot CAD/Robot Scara 3GDL/Archivos de Impresión/Tapa_Base_P6.STL

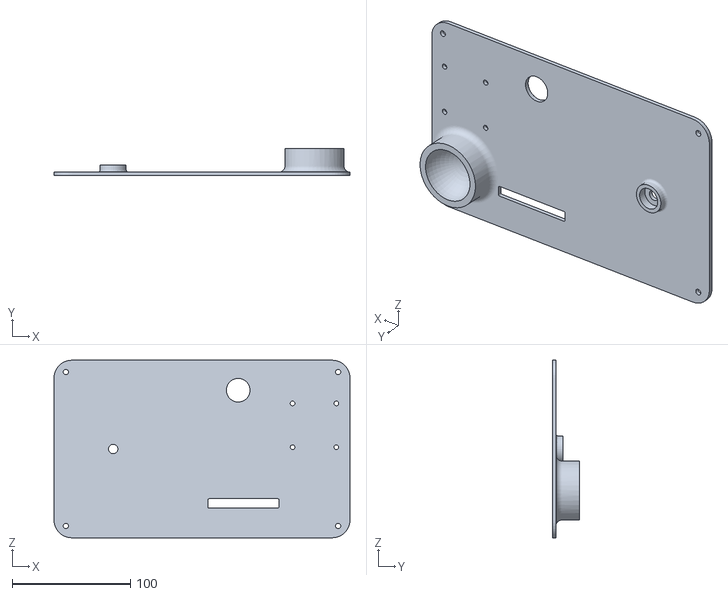
[picture p24: CAD file, 2026-03-20]
Corte_2/Robot CAD/Robot Scara 3GDL/Archivos de Impresión/Tapa_Base_P6.STL
250.0 x 23.0 x 150.0
