LauMahecha/Robotica/Corte_2/Robot CAD/Robot Scara 3GDL/Polea_Pequeña_P5.SLDPRT

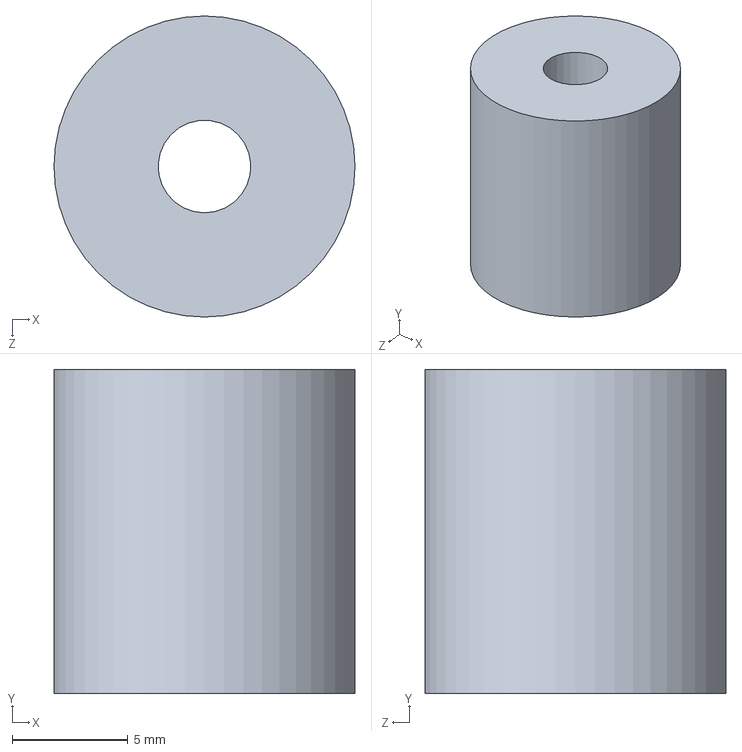
[picture p25: CAD file, 2026-03-20]
Corte_2/Robot CAD/Robot Scara 3GDL/Polea_Pequeña_P5.SLDPRT
13.0 x 14.0 x 13.0 mm
