LauMahecha/Robotica/Corte_2/Robot CAD/Robot Scara 3GDL/Archivos de Impresión/Brazo_1_P8.STL

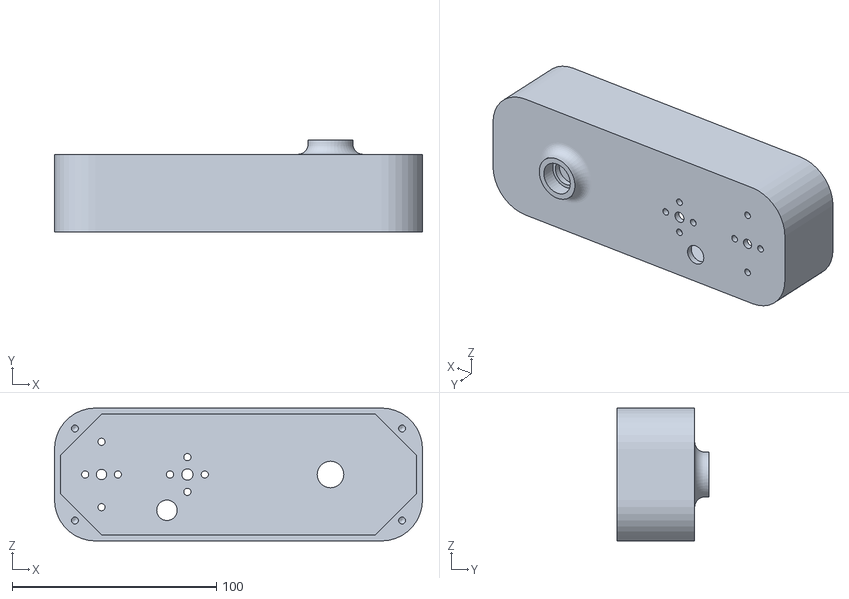
[picture p26: CAD file, 2026-03-20]
Corte_2/Robot CAD/Robot Scara 3GDL/Archivos de Impresión/Brazo_1_P8.STL
180.0 x 45.0 x 65.0
