LauMahecha/Robotica/Corte_2/Robot CAD/Robot Scara 3GDL/Tuerca_Tornillo_Bolas.SLDPRT

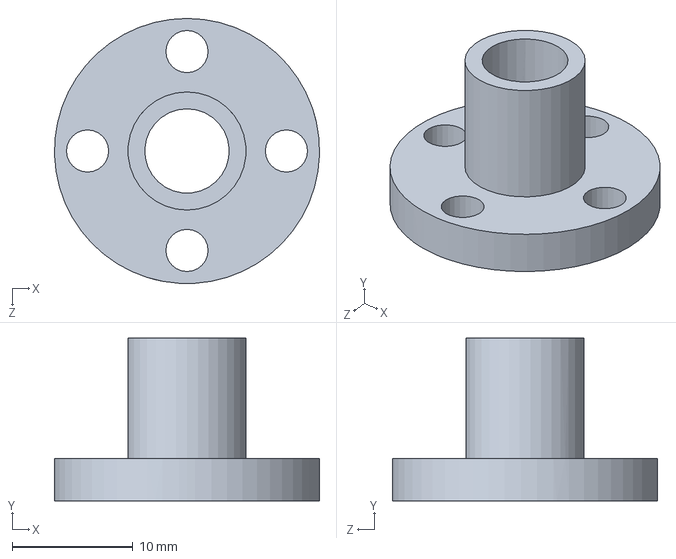
[picture p27: CAD file, 2026-03-20]
Corte_2/Robot CAD/Robot Scara 3GDL/Tuerca_Tornillo_Bolas.SLDPRT
22.0 x 13.5 x 22.0 mm
