LauMahecha/Robotica/Corte_2/Robot CAD/Robot Scara 3GDL/Archivos de Impresión/Base_Motor_1_P3.STL

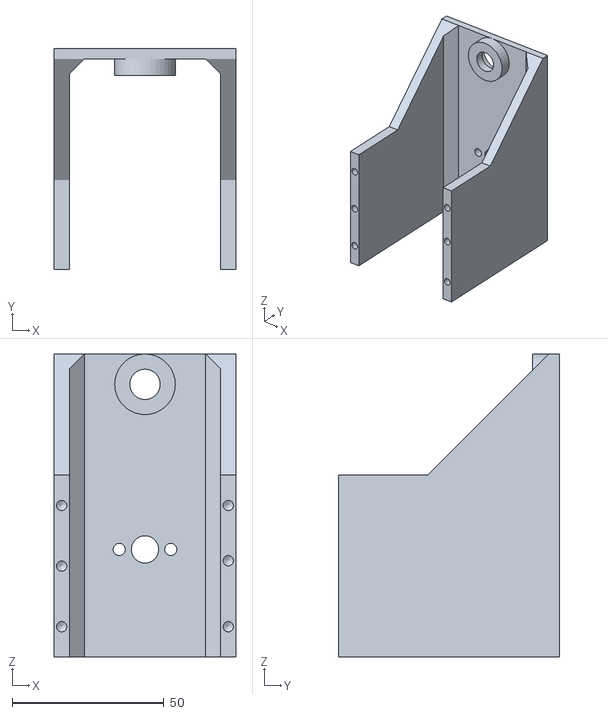
[picture p28: CAD file, 2026-03-20]
Corte_2/Robot CAD/Robot Scara 3GDL/Archivos de Impresión/Base_Motor_1_P3.STL
60.0 x 73.0 x 100.0
