LauMahecha/Robotica/Corte_2/Robot CAD/Robot Scara 3GDL/Varilla_Acero_2_P10.SLDPRT

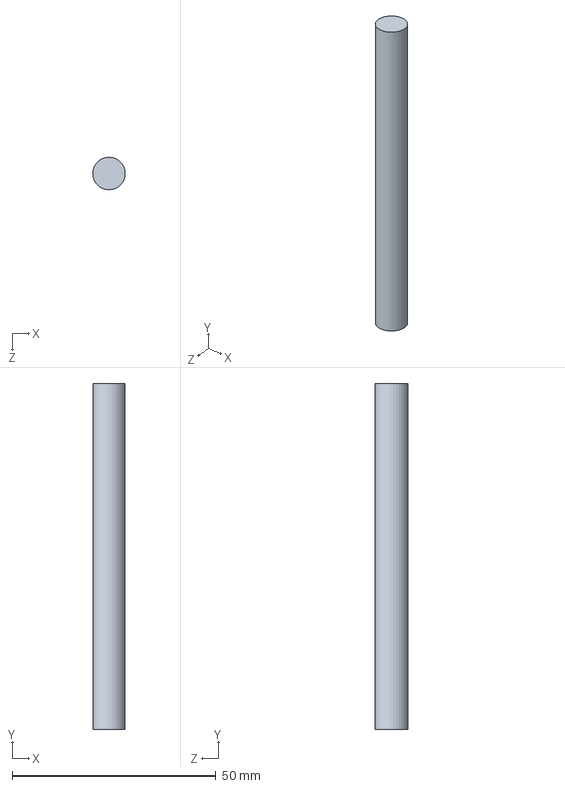
[picture p29: CAD file, 2026-03-20]
Corte_2/Robot CAD/Robot Scara 3GDL/Varilla_Acero_2_P10.SLDPRT
7.97 x 85.0 x 8.00 mm
