LauMahecha/Robotica/Corte_2/Robot CAD/Robot Scara 3GDL/Archivos de Impresión/Brazo_2_P9.SLDPRT

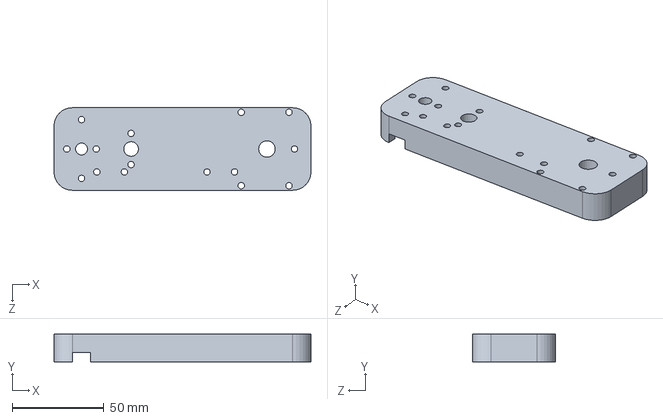
[picture p30: CAD file, 2026-03-20]
Corte_2/Robot CAD/Robot Scara 3GDL/Archivos de Impresión/Brazo_2_P9.SLDPRT
140.0 x 15.0 x 45.0 mm
