LauMahecha/Robotica/Corte_2/Robot CAD/Robot Scara 3GDL/Archivos de Impresión/Gripper_Volumetrico.STL

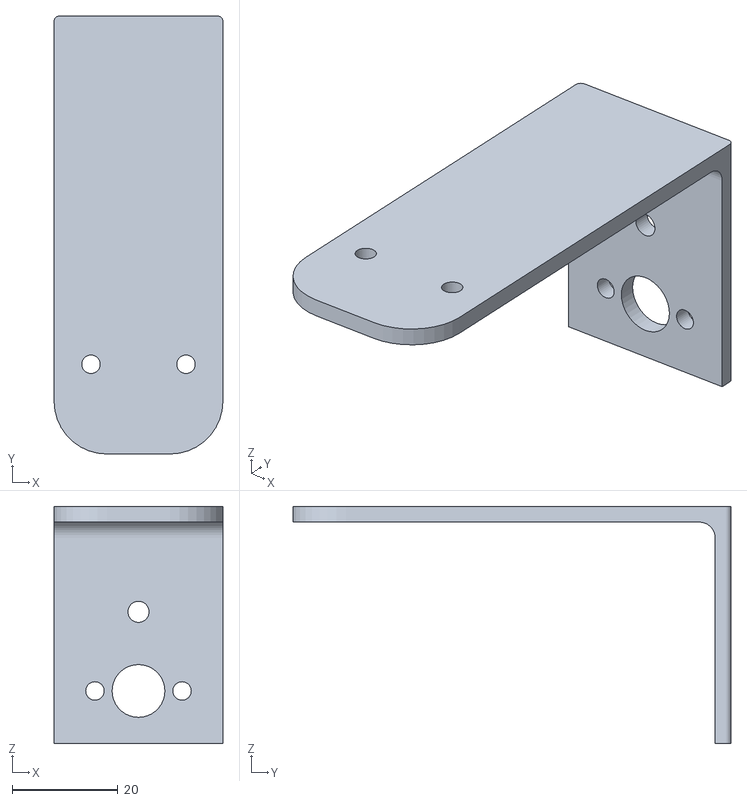
[picture p31: CAD file, 2026-03-20]
Corte_2/Robot CAD/Robot Scara 3GDL/Archivos de Impresión/Gripper_Volumetrico.STL
32.0 x 83.0 x 45.0
