LauMahecha/Robotica/Corte_2/Robot CAD/Robot Scara 3GDL/Archivos de Impresión/Base_Eje_Prismatico_P11.STL

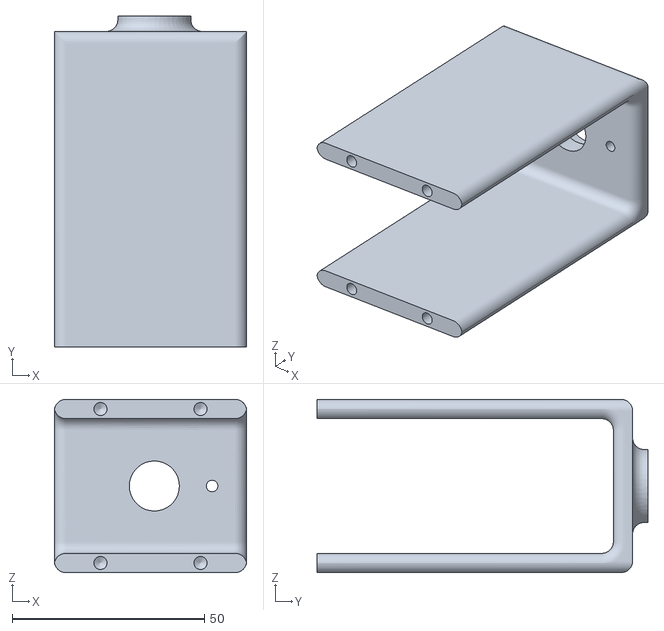
[picture p32: CAD file, 2026-03-20]
Corte_2/Robot CAD/Robot Scara 3GDL/Archivos de Impresión/Base_Eje_Prismatico_P11.STL
50.0 x 86.0 x 45.0
