LauMahecha/Robotica/Corte_2/Robot CAD/Robot Scara 3GDL/Polea_Grande_P4.SLDPRT

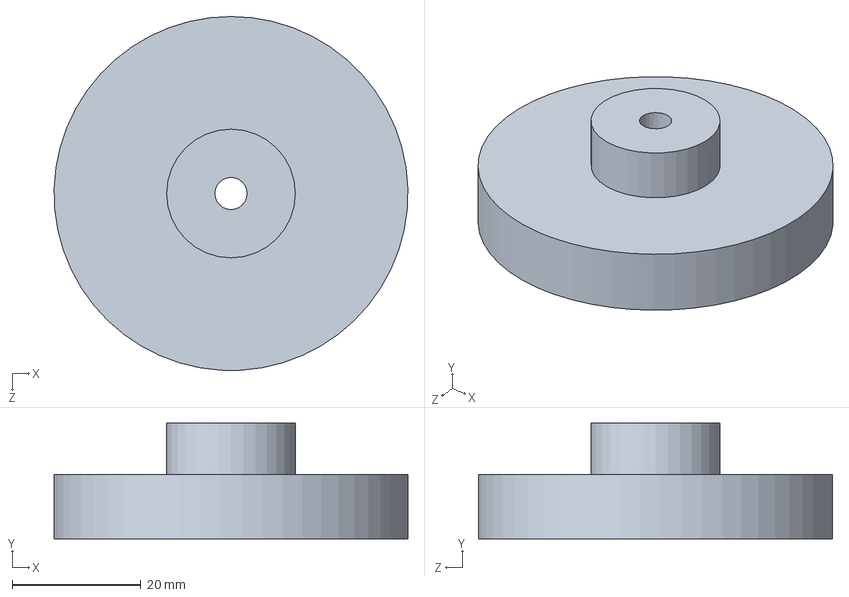
[picture p33: CAD file, 2026-03-20]
Corte_2/Robot CAD/Robot Scara 3GDL/Polea_Grande_P4.SLDPRT
55.0 x 18.0 x 55.0 mm
