LauMahecha/Robotica/Corte_2/Robot CAD/Robot Scara 3GDL/MOTOR.SLDPRT

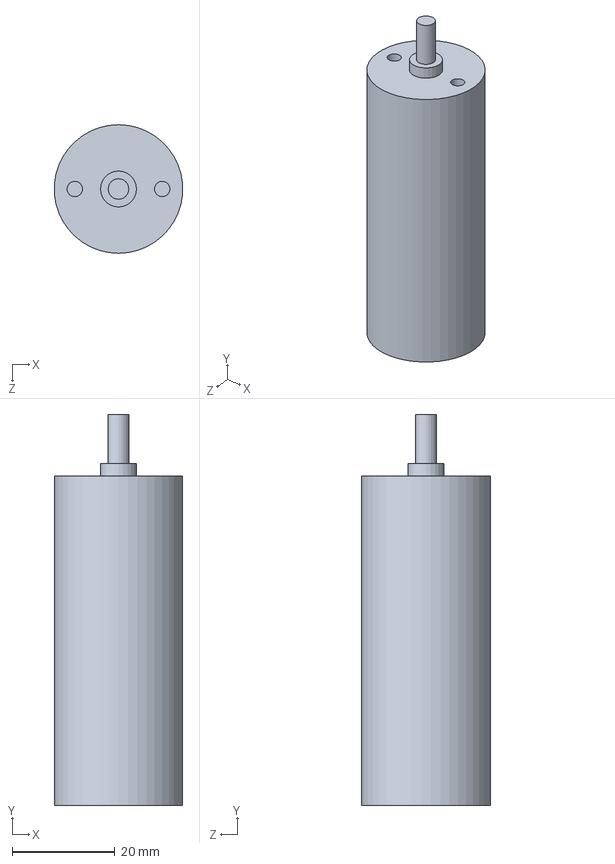
[picture p34: CAD file, 2026-03-20]
Corte_2/Robot CAD/Robot Scara 3GDL/MOTOR.SLDPRT
24.9 x 76.0 x 25.0 mm
