LauMahecha/Robotica/Corte_2/Robot CAD/Robot Scara 3GDL/Guia Eje Prismatico.SLDPRT

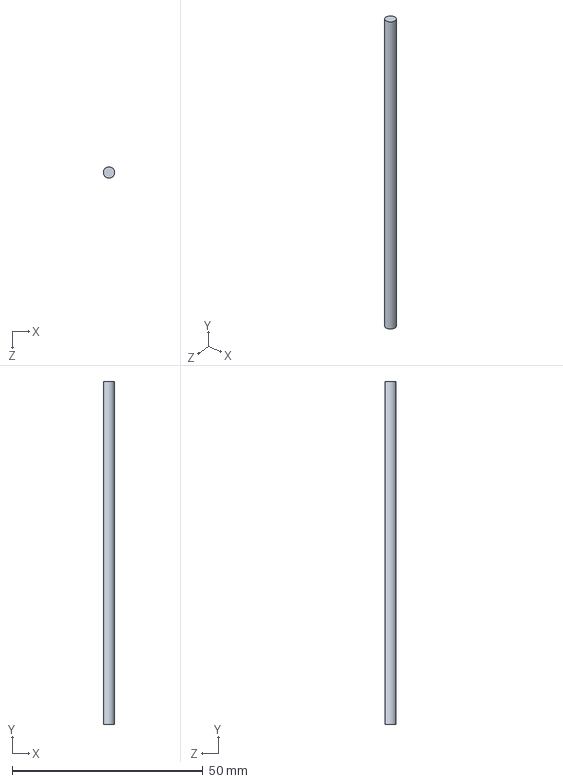
[picture p35: CAD file, 2026-03-20]
Corte_2/Robot CAD/Robot Scara 3GDL/Guia Eje Prismatico.SLDPRT
2.99 x 90.0 x 3.00 mm
