LauMahecha/Robotica/Corte_2/Robot CAD/Robot Scara 3GDL/tornillo de bolas.SLDPRT

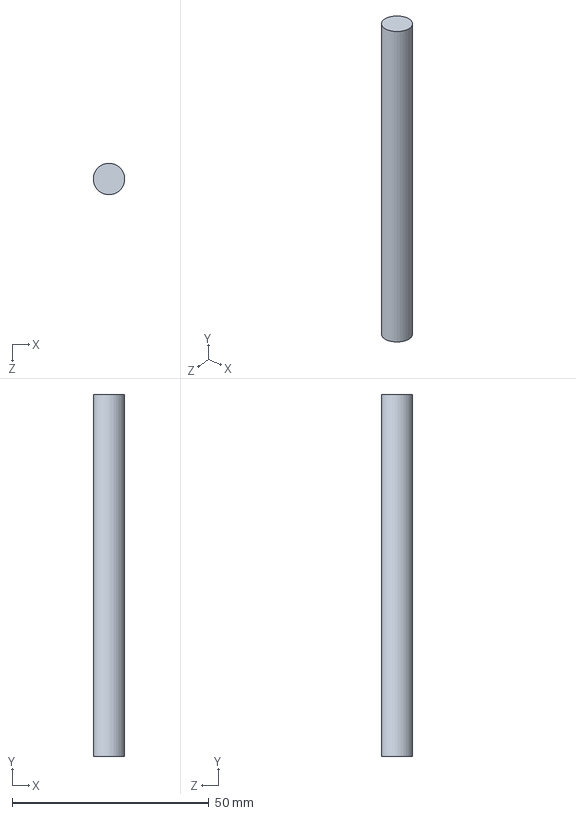
[picture p36: CAD file, 2026-03-20]
Corte_2/Robot CAD/Robot Scara 3GDL/tornillo de bolas.SLDPRT
7.99 x 92.0 x 8.00 mm
