LauMahecha/Robotica/Corte_2/Robot CAD/Robot Scara 3GDL/Tornillo de Bolas_P12.SLDPRT

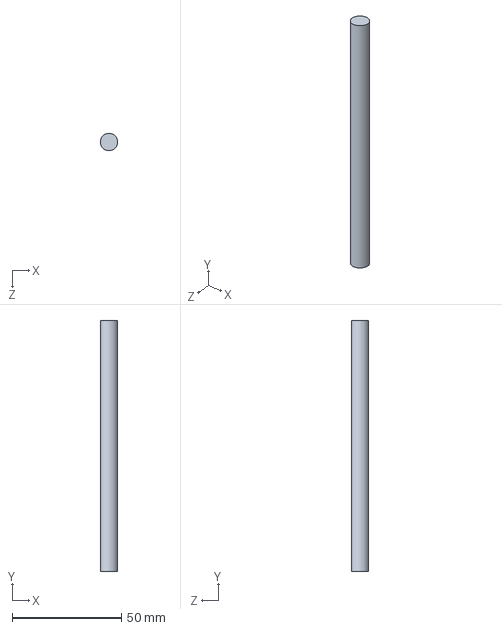
[picture p37: CAD file, 2026-03-20]
Corte_2/Robot CAD/Robot Scara 3GDL/Tornillo de Bolas_P12.SLDPRT
8.00 x 115.0 x 8.00 mm
