LauMahecha/Robotica/Corte_2/Robot CAD/Robot Scara 3GDL/Cama ampolleta.SLDPRT

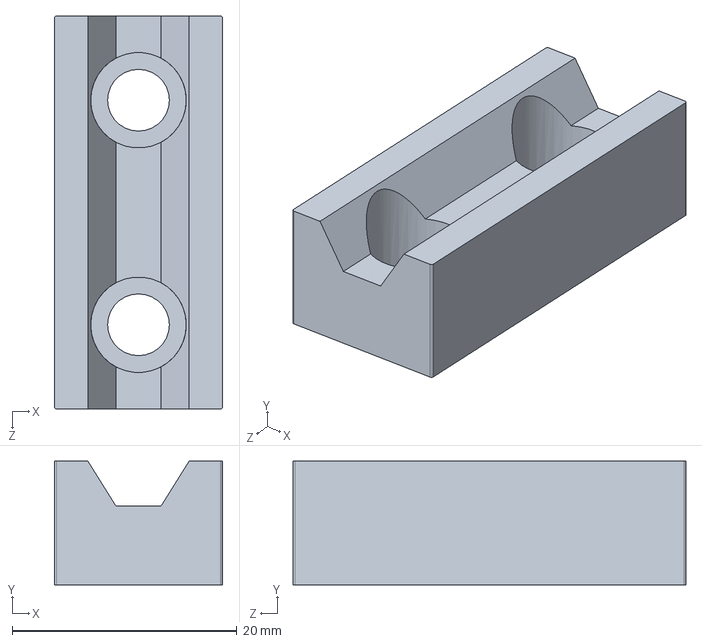
[picture p38: CAD file, 2026-03-20]
Corte_2/Robot CAD/Robot Scara 3GDL/Cama ampolleta.SLDPRT
15.0 x 11.0 x 35.0 mm
