LauMahecha/Robotica/Corte_2/Robot CAD/Robot Scara 3GDL/Base para Tabla de Ping Pong.SLDPRT

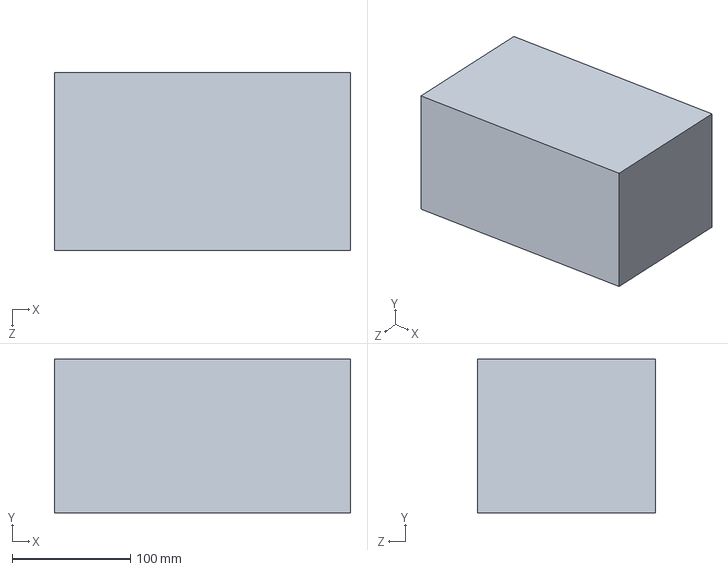
[picture p39: CAD file, 2026-03-20]
Corte_2/Robot CAD/Robot Scara 3GDL/Base para Tabla de Ping Pong.SLDPRT
250.0 x 130.0 x 150.0 mm
