LauMahecha/Robotica/Corte_2/Robot CAD/Robot Scara 3GDL/Acople_Rigido_P6.SLDPRT

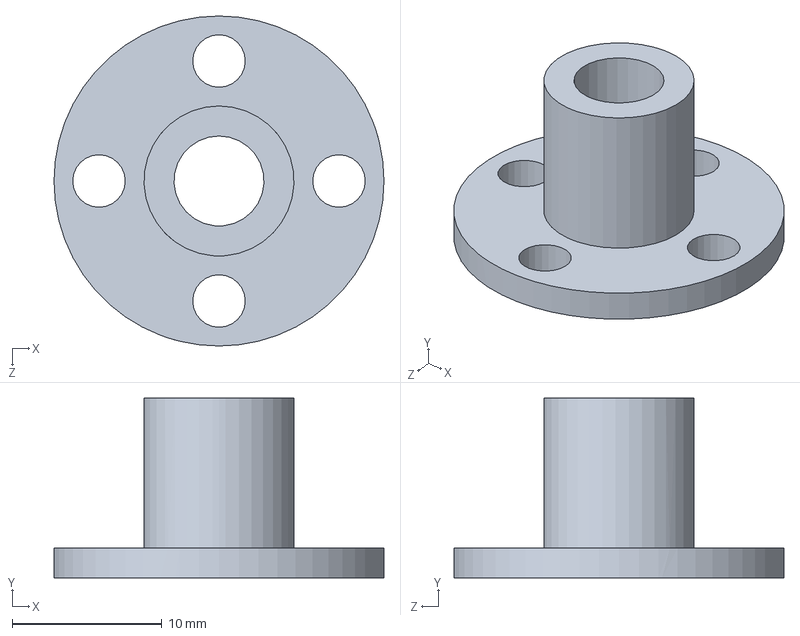
[picture p40: CAD file, 2026-03-20]
Corte_2/Robot CAD/Robot Scara 3GDL/Acople_Rigido_P6.SLDPRT
22.0 x 12.0 x 22.0 mm
