LauMahecha/Robotica/(list of files, cad)

Other CAD files:
Corte_2/Robot CAD/Robot Scara 3GDL/Base_Motor_1_P3.SLDPRT
Corte_2/Robot CAD/Robot Scara 3GDL/Tapa Eslabon 1.SLDPRT
Corte_2/Robot CAD/Robot Scara 3GDL/Base_Robot_P1.SLDPRT
Corte_2/Robot CAD/Robot Scara 3GDL/Tapa_Base_P6.SLDPRT
Corte_2/Robot CAD/Robot Scara 3GDL/Gripper_Volumetrico.SLDPRT
Corte_2/Robot CAD/Robot Scara 3GDL/Brazo_1_P8.SLDPRT
Corte_2/Robot CAD/Robot Scara 3GDL/plano basico.SLDPRT
Corte_2/Robot CAD/Robot Scara 3GDL/Base_Eje_Prismatico_P11.SLDPRT
Corte_2/Robot CAD/Robot Scara 3GDL/Archivos de Impresión/Brazo_2_P9.STL
Corte_2/Robot CAD/Robot Scara 3GDL/Cama ampolleta.STL
