LauMahecha/Robotica/Corte_2/Robot CAD/Imagenes ensamblaje/WhatsApp Image 2026-03-20 at 9.59.28 AM (3).jpeg

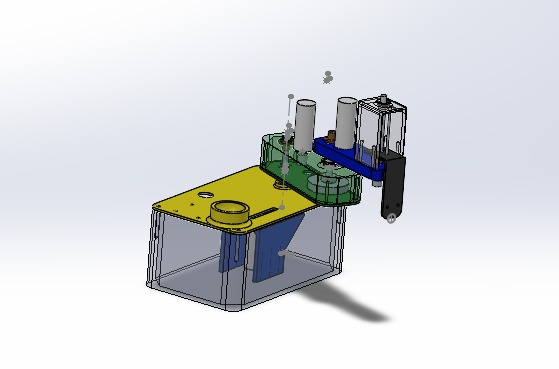
Corte_2/Robot CAD/Imagenes ensamblaje/WhatsApp Image 2026-03-20 at 9.59.28 AM (3).jpeg
